ead0601/mioc-verilog/doc/mioc_flop_nmos.png

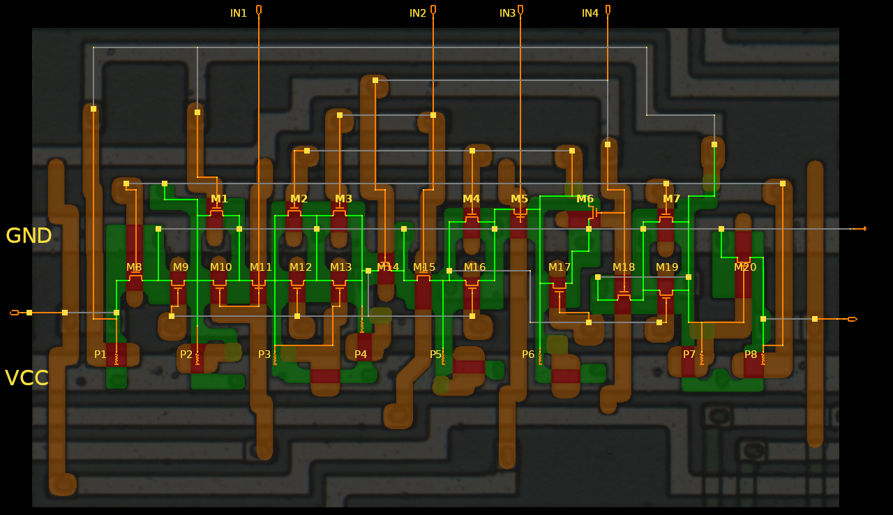
doc/mioc_flop_nmos.png
