ead0601/mioc-verilog/doc/mioc-scaled-down.png

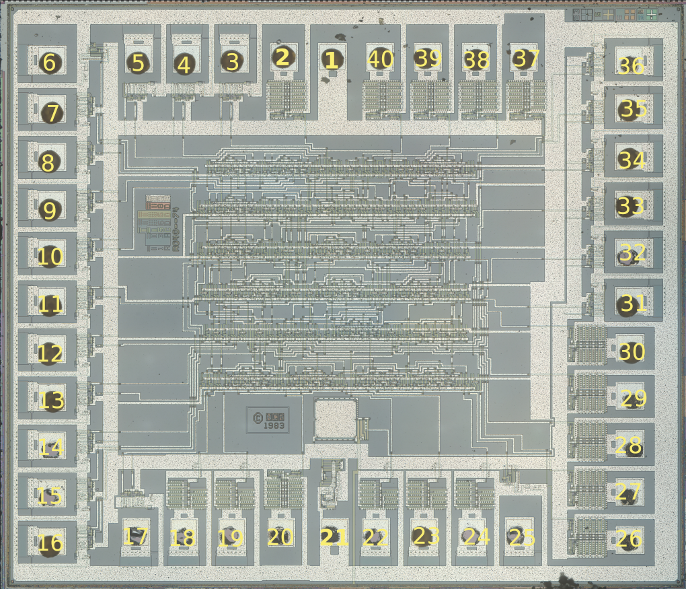
doc/mioc-scaled-down.png
