ead0601/mioc-verilog/doc/mioc_flop_gates.png

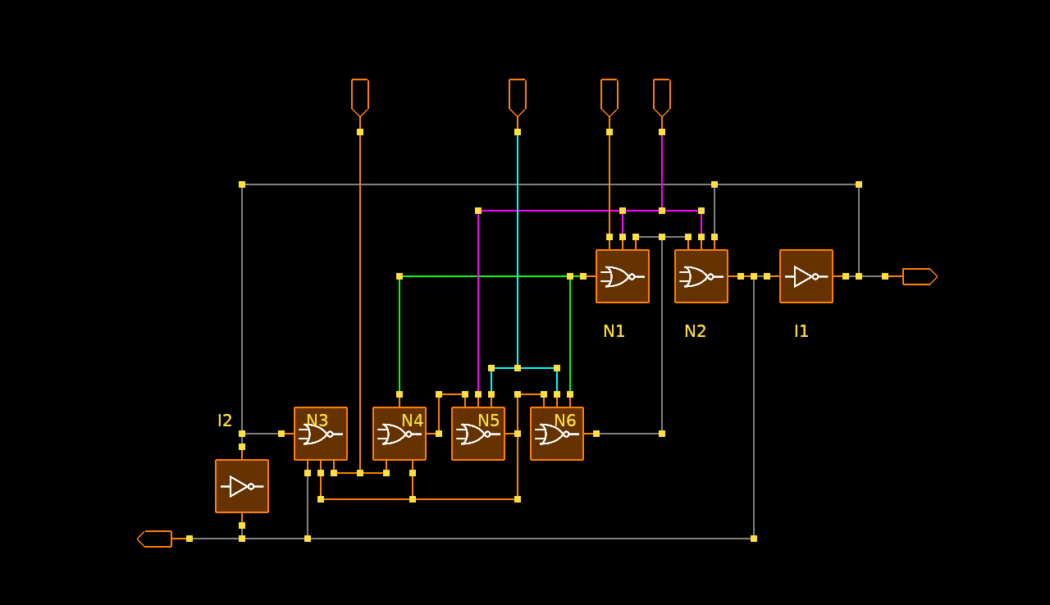
doc/mioc_flop_gates.png
