ead0601/mioc-verilog/doc/mioc_nand4_nor2.png

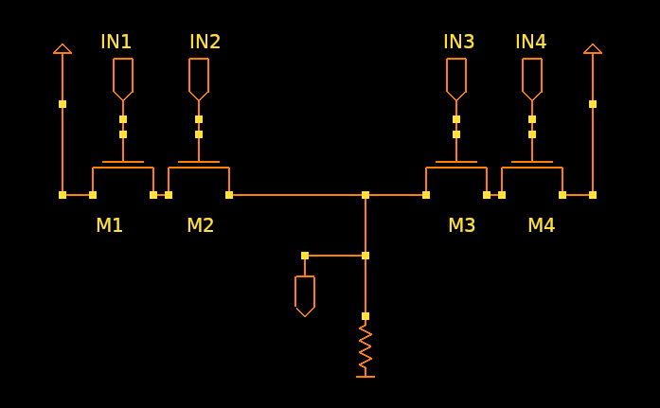
doc/mioc_nand4_nor2.png
