ead0601/mioc-verilog/doc/top_level_schematic.png

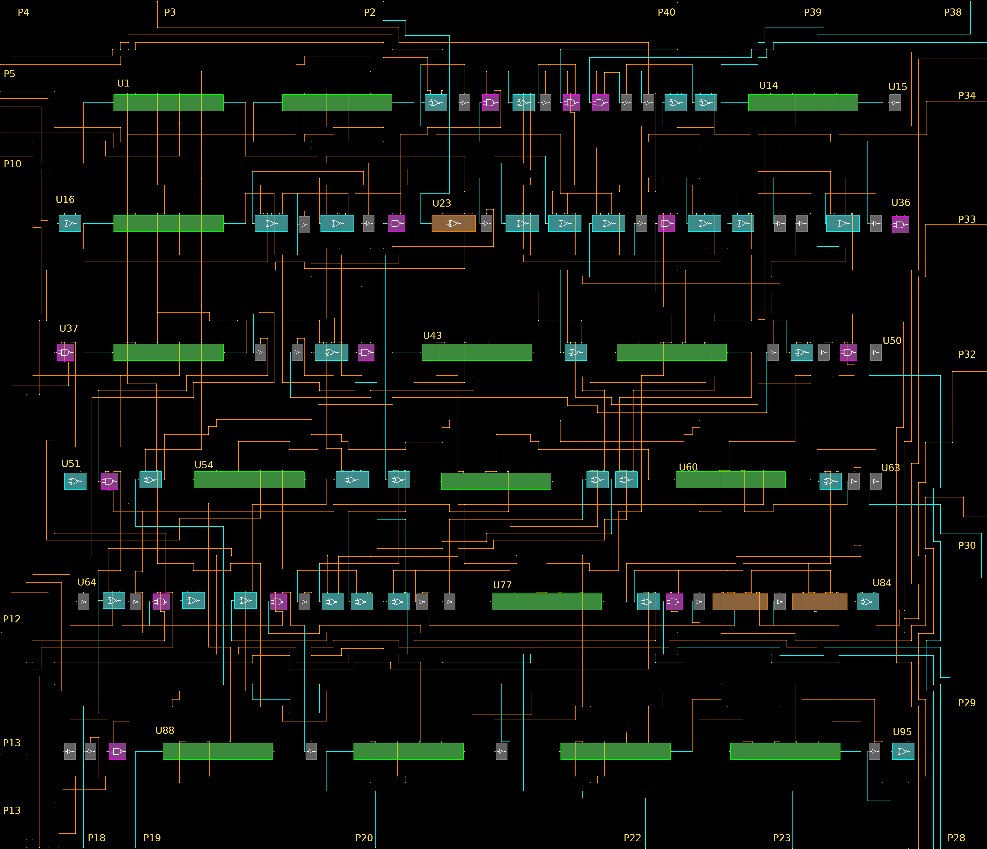
doc/top_level_schematic.png
