ead0601/mioc-verilog/mioc-sandwich-pcb/mioc-sandwich-pcb.kicad_pcb

## KiCad design ControlBoard/ControlBoard/ControlBoard.kicad_sch

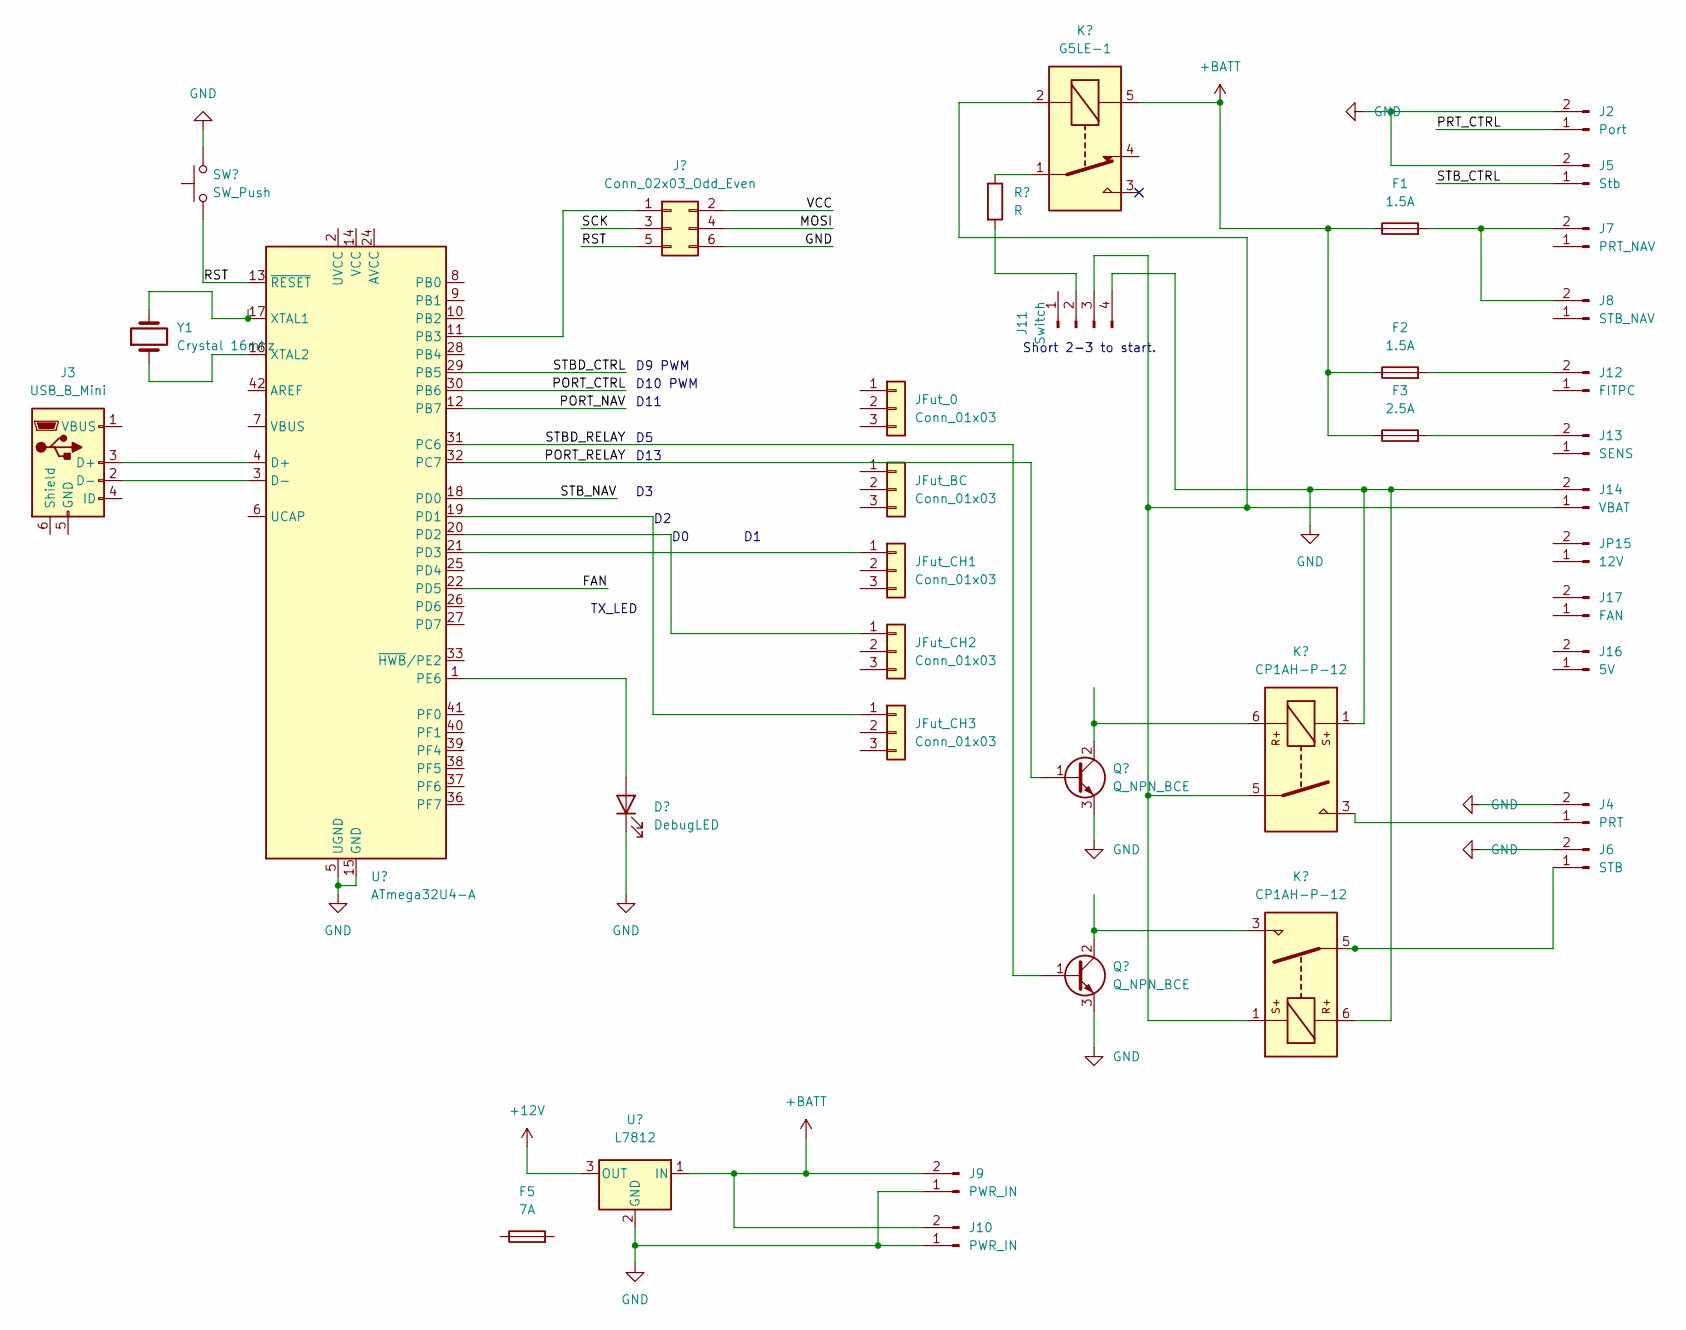
[picture p6: schematic ControlBoard.kicad_sch]

Parts:
F1, F2: 1.5A
F3: 2.5A
F5: 7A
J2: Port
J3: USB_B_Mini
J4: PRT
J5: Stb
J6: STB
J7: PRT_NAV
J8: STB_NAV
J9, J10: PWR_IN
J11: Switch
J12: FITPC
J13: SENS
J14: VBAT
J16: 5V
J17: FAN
JFut_0: Conn_01x03
JFut_BC: Conn_01x03
JFut_CH1, JFut_CH2, JFut_CH3: Conn_01x03
JP15: 12V
Y1: Crystal 16mhz

Connections:
unnamed: F1.1, F2.1, F3.1
unnamed: F1.2, J7.2, J8.2
unnamed: F2.2, J12.2
unnamed: F3.2, J13.2
unnamed: J2.2, J5.2
unnamed: J9.1, J10.1
unnamed: J9.2, J10.2
unnamed: J11.3, J14.1
unnamed: J11.4, J14.2
PRT_CTRL: J2.1
STB_CTRL: J5.1

Notes on the sheet:
D10 PWM
TX_LED
D11
D9 PWM
D13
Short 2-3 to start.
