ead0601/mioc-verilog/(commit log)

2022-08-22 updated input pattern to test reset
    [testbench.v]
2022-08-22 had to change the tri0 tri1 to wire declaration. set/reset is workinggit add .
    [mioc_flop_nmos.v]
2022-08-23 switched q and qbar
2022-08-24 added pin lables, pin 13 is a special io pad need to investigate
2022-08-24 added wire assignments needed for external pad to internal wire selection.
2022-08-25 fixed bugs not found with icarus, but found with cadence
    [mioc_flop_nmos.v, mioc_inv1_nmos.v, mioc_xnor2_nmos.v]
2022-08-25 fixed non blocking assignment
    [testbench.v]
2022-08-27 fixed naming of input pins
    [mioc_top.v]
2022-08-28 mioc is reseting...fixed bugs in top level, and a real design issue exists with game reset and adam reset going to latch U2 causing a set and reset to occur together...so dont do that.
    [mioc_top.v, testbench.v]
2022-08-28 modified SR latch to handle unknown condition that occurs with component U2, and adam/computer reset.
    [mioc_flop_rtl.v]
2022-08-28 fixed testbench so that CAS would toggle, was missing driving Z80 bus ack
    [testbench.v]
2022-09-02 KiCad symbol for original MIOC
    [mioc-sandwich-pcb.kicad_pcb, mioc-sandwich-pcb.kicad_sch]
2022-09-02 Very rough CPLD footprint for sizing
2022-09-08 fixed typo bug net u74z was unconnected
    [compxlib.cfg, mioc_flop_xilinx.sch]
2022-09-09 SUCCESSgit status! Xilinx ISE memory testbench running, found major testbench bug, plus other human typos in toplevel rtl.
    [compxlib.cfg, mioc_flop_xilinx.sch]
2022-09-10 general cleanup and updated test-002
    [compxlib.cfg]
